pedroazara/estacao-metereologica/ferramentas/cnc-jog/relatorio.html

← Voltar ao painel

OFICINA / DOCUMENTAÇÃO DO LABORATÓRIO

# CNC: guia de JOG e diagnóstico

Inspeção por USB em 7 de outubro de 2026 · estado de comissionamento parcial

A controladora foi identificada como BTT SKR V1.4 Turbo com grblHAL 1.1f, compilação 20250329, cinemática CoreXZ v2.02. Há comunicação USB e aceitação de comandos. A movimentação física, a calibração, os sentidos, os sensores e o spindle não foram validados. Durante os primeiros testes, o operador relatou não perceber movimento.

## O que o painel faz

1. Deixe o monitor serial anterior desconectado: apenas um programa deve acessar a porta USB.
2. Selecione /dev/ttyACM0 · SKR / NXP e clique em Conectar. O painel consulta a identificação, o estado do interpretador e os parâmetros. Conectar não envia movimento, homing, reset ou comando de spindle.
3. Escolha o modo de controle. Para o primeiro teste físico, use Por clique, distância de 0,1 mm, velocidade X/Y de 60 mm/min e Z de 30 mm/min.
4. Confira pessoalmente a área livre e o spindle parado; marque a confirmação e clique em Habilitar JOG.
5. No modo Por clique, clique uma vez no eixo desejado. Aguarde o retorno ao estado Idle. Esse modo não repete movimentos ao segurar.
6. Para interromper um JOG e bloquear os controles, clique em Cancelar JOG ou pressione Esc. O cancelamento usa o byte 0x85 do grblHAL e depende do computador/USB; não substitui uma parada física.
7. Desconecte o painel ao terminar. Para encerrar o servidor, use Ctrl+C no terminal onde ele foi iniciado.

## Controle contínuo: botões e mouse

Depois de validar os sentidos físicos por clique, escolha Segurar para mover e habilite novamente os controles. Mantenha pressionado um botão de direção para solicitar movimento. Soltar cancela; aguarde a confirmação da parada antes de iniciar outro acionamento. As velocidades X/Y e Z continuam independentes. A distância por clique não é usada nesse modo.

No joystick X/Y, pressione e arraste para fora do centro, mantendo pressionado. O eixo predominante determina a direção: apenas X ou Y por vez, sem diagonais. Quanto mais longe do centro, maior a velocidade, de 60 mm/min até o máximo definido no campo X/Y. Voltar ao centro cancela e exige soltar antes de iniciar outro gesto. Mover o mouse sem pressionar não controla a CNC. Para Z, use os botões separados.

Cada acionamento tem limite de 10 segundos e de deslocamento solicitado acumulado: 10 mm em X/Y ou 3 mm em Z. Os deslocamentos de ida e volta contam, não só a posição final. Atingir um limite bloqueia os controles; confira a folga e habilite novamente. Esses limites locais não detectam a borda da máquina nem substituem sensores.

O servidor envia trechos curtos, de até 150 ms de deslocamento comandado, sem fila longa, aguardando confirmação e estado Idle entre os trechos. Portanto, pode haver pequenas pulsações em vez de movimento perfeitamente uniforme. Soltar solicita cancelamento imediato, mas desaceleração e atraso de comunicação existem. Sem renovação do gesto por 600 ms, o servidor cancela e bloqueia. Perder foco, trocar de aba ou de modo também bloqueia. Pacotes atrasados de um acionamento encerrado não devem iniciar outro.

Após cancelar, o painel consulta o interpretador e aguarda confirmação de parada antes de permitir outro movimento. Não há acionamento automático de spindle, homing ou alteração dos parâmetros gravados. Os testes do novo controle usam somente simulador e portas virtuais; o comportamento físico precisa ser validado presencialmente, com spindle desligado e parada física acessível.

Demonstração: selecione “Demonstração · sem CNC”. Um simulador local recebe os comandos e calcula posições virtuais; não abre nenhuma porta serial. O aviso roxo identifica esse modo. A demonstração serve para aprender o painel, não comprova funcionamento da máquina.

## Correção da conexão USB do painel

Na validação com a placa real em 7 de outubro de 2026, o painel anterior recebia identificação e configurações, mas não o estado atual. A conexão foi corrigida para manter DTR ativo na USB nativa LPC e consultar o estado com o comando grblHAL 0x80. A mensagem inicial de boas-vindas agora é tratada dentro da inicialização, com releitura das consultas quando necessário; só uma resposta de estado atualizada permite concluir a conexão. Uma mensagem de reinício ou mudança de sessão depois disso continua bloqueando os controles e exigindo reconexão manual.

Na verificação inicial da reconexão, a placa real respondeu Idle, posição calculada 0,0,0, avanço zero e rotação comandada zero, com controles desabilitados. A intervenção do assistente enviou somente consultas de leitura: nenhum JOG, homing, comando de spindle ou alteração de configuração. Depois dessa verificação inicial, a sessão registrou JOGs acionados pela interface, atualização das posições calculadas e alternância entre Jog e Idle. Ainda falta confirmar visualmente o movimento físico. Os 30 testes automatizados usam simulador ou portas virtuais, não a CNC física. Essa correção confirma comunicação, não movimentação ou segurança mecânica.

## Distância e velocidade são independentes

$J=G91 G21 Z1 F120 solicita deslocamento incremental de +1 mm em Z, a 120 mm/min (2 mm/s). Z-1 inverte o sentido. G91 indica deslocamento relativo e G21 fixa milímetros para esse JOG. O comando não muda o modo de coordenadas do programa principal.

Controle | X / Y | Z
Distância por clique | 0,1 · 0,5 · 1 · 5 mm | 0,1 · 0,5 · 1 · 2 mm
Velocidade permitida no painel | 60–600 mm/min | 30–240 mm/min
Valor inicial | 1 mm · 300 mm/min | 0,5 mm · 60 mm/min

Esses limites são restrições locais do painel para testes iniciais; não são capacidades mecânicas comprovadas. Não alteram os parâmetros gravados na placa. Aceleração e comprimento do movimento limitam a velocidade efetivamente atingida em deslocamentos curtos.

## Identificação comprovada

USB | NXP VCOM Port · VID:PID 1fc9:0083
Porta na inspeção | /dev/ttyACM0
Identificação persistente | /dev/serial/by-id/usb-NXP_VCOM_Port_NXP-77-if00
Placa | BTT SKR V1.4 Turbo
Firmware | grblHAL · [VER:1.1f.20250329:]
Driver de plataforma | [DRIVER:LCP1769] (grafia reportada pelo firmware), versão 250327
Eixos e cinemática | 3 · XYZ · CoreXZ v2.02
Plugins reportados | Trinamic v0.27; FS stream v1.00; FS macro v0.17; SDCARD v1.23

A origem do conjunto mecânico não foi identificada. A hipótese anterior de “Cyclone PCB Factory modificada” não tem comprovação e não deve orientar ligações, firmware ou medidas. A controladora é um componente comercial; isso não identifica um modelo comercial da máquina inteira.

## Parâmetros lidos na inspeção

Parâmetro | Valor lido | Interpretação / limite da evidência
$100 / $101 / $102 | 80,080 / 80,000 / 80,080 | Passos/mm configurados para X/Y/Z; calibração não medida.
$110 / $111 / $112 | 10.000 / 10.000 / 10.000 | Velocidades máximas em mm/min; não são velocidades validadas.
$120 / $121 / $122 | 400 / 400 / 400 | Acelerações em mm/s².
$130 / $131 / $132 | 200 / 200 / 200 | Cursos declarados, não medidos. Não assumir volume físico de 200³ mm.
$20 / $21 / $40 | 0 / 0 / 0 | Limites por software, limites físicos e limitação de JOG desativados.
$140 / $141 / $142 | 900 / 900 / 900 | Correntes configuradas, mA RMS. Corrente real e compatibilidade dos motores não verificadas.
$150 / $151 / $152 | 16 / 16 / 16 | Micropassos configurados.
$338 / $339 | 7 / 5 | Trinamic habilitado em XYZ; sensorless homing configurado em X/Z.
$22 | 563 | Homing habilitado, eixos individuais, switches compartilhados, homing manual permitido e velocidades por eixo. Não exige homing ao iniciar.
$44 / $45 / $46 | 1 / 0 / 0 | A primeira passagem de homing está configurada apenas para X.
$23 / $27 | 0 / 1,000 | Busca no sentido positivo e recuo de 1 mm, conforme ajuda desta compilação.
$30 / $33 | 12.000 / 5.000 | Escala máxima de spindle em rpm e frequência PWM em Hz; não comprova ligação nem rotação real.
$5 / $18 / $14 | 5 / 2 / 1 | Inversões/pull-ups das entradas precisam ser confrontados com a fiação.

O painel lê os parâmetros novamente a cada conexão. O diagnóstico exportado contém os valores da sessão atual; as tabelas deste guia são um registro histórico, não um backup completo para restauração.

## Estado e testes observados

A controladora reportou Idle, FS:0,0 e Pn:HSP. H e S correspondem às entradas de feed hold/cycle start; P, à sonda. A presença simultânea deve ser investigada presencialmente. $LIM retornou [LIMITS:,,,]; isso só descreve o estado naquele instante, não testa a funcionalidade dos sensores.

Foram aceitos JOGs de ida e volta de 0,1 mm nos três eixos, depois 1 mm em X/Y e 0,5 mm em Z, e posteriormente 5 mm em X/Y e 2 mm em Z. As coordenadas calculadas voltaram a 0,0,0. Não houve confirmação visual do movimento; resposta ok e mudança de MPos não provam alimentação, torque, passos efetivos ou ausência de travamento. $SDS respondeu somente ok, sem diagnóstico detalhado de drivers.

Houve um teste de interpretação em modo Check, incluindo G0/G1/M3/M5: ele não era um teste de spindle físico. A sessão depois saiu desse modo por reset lógico. O painel atual não oferece modo Check, reset, desbloqueio de alarmes, homing, spindle ou execução de arquivos.

O offset G54 lido era 24.756,1.403,-0.090. O registro HOME indicava máscara de eixos referenciados igual a zero. Não tratar MPos zero como home mecânico nem usar offsets antigos para cortar. A montagem do SD respondeu ok, mas a listagem retornou error:62 — Directory listing failed; nenhum arquivo foi recuperado.

## Mapa de pinos reportado pelo firmware

Função | Pinos
Passo X / Y / Z | P2.2 / P0.19 / P0.22
Direção X / Y / Z | P2.6 / P0.20 / P2.11
Enable X / Y / Z | P2.1 / P2.8 / P0.21
UART drivers X / Y / Z | P1.10 / P1.9 / P1.8
Limites X / Y / Z | P1.29 / P1.28 / P1.27
Reset / Hold / Start | P0.18 / P0.16 / P0.15
Sonda | P0.10
Spindle enable / direção / PWM | P1.23 / P1.21 / P2.4
Mist / Flood | P1.30 / P1.19

São pinos lógicos declarados pela compilação. Não constituem um diagrama de fiação verificado. Não reconectar componentes com base somente nesta tabela. Em CoreXZ, movimentos X e Z podem envolver motores combinados; não inverter um motor ou aplicar passos/mm de máquina cartesiana sem mapear a transmissão.

## Se os números mudarem e a CNC não mexer

Interrompa os testes e confirme com o responsável pelo laboratório a alimentação de potência dos drivers e motores, o estado dos drivers e seus sinais de enable, e a compatibilidade da compilação CoreXZ com a mecânica instalada. Uma placa alimentada pelo USB pode responder normalmente sem fornecer potência aos motores. Não aumente distâncias ou velocidades para compensar ausência de movimento. Inspeções em conectores ou jumpers devem ser feitas com fonte e USB desconectados.

## Antes de passar de JOG para usinagem

Faltam: observar e medir deslocamentos reais, mapear sentidos, identificar motores/drivers e transmissão, medir o curso útil, verificar fixação e folgas, testar entradas individualmente, resolver HSP, validar parada física e proteções, definir homing compatível com CoreXZ, configurar limites a partir das medidas e caracterizar o spindle e a fixação da ferramenta. Depois disso, preparar peça no CAD/CAM com pós-processador compatível com esta compilação grblHAL, definir zero de trabalho e simular a trajetória. A primeira execução deve ser acompanhada e afastada do material; só depois validar corte. Este painel é destinado ao posicionamento manual, não ao envio de programas de usinagem.

## Fontes e manutenção

- Documentação oficial BTT SKR V1.4 / Turbo (https://github.com/bigtreetech/BIGTREETECH-SKR-V1.3/tree/master/BTT%20SKR%20V1.4)
- grblHAL: comandos em tempo real, incluindo JOG CANCEL 0x85 (https://github.com/grblHAL/core/blob/master/grbl.h)
- Grbl: semântica de JOG incremental (https://github.com/gnea/grbl/wiki/Grbl-v1.1-Jogging)
- Evidências da inspeção: respostas de $I, $$, $HELP SETTINGS, $#, $G, $N, $PINS, $LIM, $SDS e relatórios de estado, registradas na conversa deste laboratório.

Para reabrir: no diretório cnc-jog, execute python3 server.py e abra http://127.0.0.1:8765. Dependência: pyserial 3.5. O serviço aceita conexões apenas deste computador, usa proteção de origem/token e não se reconecta ou habilita movimento automaticamente. Trocar de aba bloqueia os controles; perda de heartbeat por 2 s ou do estado serial por 1,5 s solicita cancelamento. Se o cabo for retirado, não há garantia de entrega do cancelamento: o limite de distância por comando reduz a exposição, e a parada física continua necessária.
