pedroazara/estacao-metereologica/docs/README.md

# Documentação técnica

- [Documento consolidado](versoes/2026-10-10-2cd5977-local/documentacao-tecnica.md): captura do estado analisado em 10/10/2026, com imagens, fontes, limitações e evidências.
- [Organização e limpeza](organizacao/2026-10-10/relatorio.md): estrutura atual, movimentos, remoções e verificações.
- [Arquitetura e telemetria](04-telemetria.md): fluxo atual e decisões anteriores identificadas como históricas.
- [Base Raspberry Pi](05-base-raspberry-pi.md): operação atual por HTTP e notas de implantação.
- [Hardware](../hardware/README.md), [firmware](../firmware/README.md) e [aplicativo](../app/README.md): entradas de cada componente.

Os documentos `01`, `02` e `03` registram conhecimentos de conexão, protocolo
WTG e Kalman. São referências técnicas históricas. Os testes/exercícios antigos
foram removidos a pedido; a matemática e os registros documentais foram mantidos.
A pasta `versoes` preserva a captura da análise, mesmo quando um arquivo-fonte
antigo deixa de fazer parte da árvore ativa.
