pedroazara/estacao-metereologica/docs/organizacao/2026-10-10/inventario-readmes.md

# Inventário atual de READMEs e variantes

Data: 10/10/2026, após organização e limpeza. Ambientes virtuais, dependências
de compilação e metadados Git não são documentação autoral.

Total na árvore de autoria/referência: **13**. Sem pendências.

| Caminho | Situação |
|---|---|
| `README.md` | Criado ou atualizado para a estrutura atual |
| `app/README.md` | Criado ou atualizado para a estrutura atual |
| `docs/README.md` | Criado ou atualizado para a estrutura atual |
| `ferramentas/README.md` | Criado ou atualizado para a estrutura atual |
| `ferramentas/cnc-jog/LEIA-ME.txt` | Revisado sem alteração; guia local continua válido |
| `ferramentas/cnc-jog/exemplos/LEIA_ANTES_DO_RASCUNHO.txt` | Revisado sem alteração; guia local continua válido |
| `firmware/README.md` | Criado ou atualizado para a estrutura atual |
| `hardware/README.md` | Criado ou atualizado para a estrutura atual |
| `hardware/skylog/README.md` | Criado ou atualizado para a estrutura atual |
| `hardware/skylog/bibliotecas/README.md` | Criado ou atualizado para a estrutura atual |
| `hardware/skylog/bibliotecas/Sensores_Modulos/originais/gy302/readme.md` | Excluído: original de terceiro, preservado com procedência/licença |
| `hardware/skylog/fabricacao/README.md` | Criado ou atualizado para a estrutura atual |
| `src/README.md` | Criado ou atualizado para a estrutura atual |

Relatórios de cobertura são registros de revisão e não entram no total de READMEs.
