pedroazara/estacao-metereologica/hardware/skylog/modelos/esp32-wroom-32s-nodemcu-32s-1.snapshot.8/ESP32Wroom4.STEP

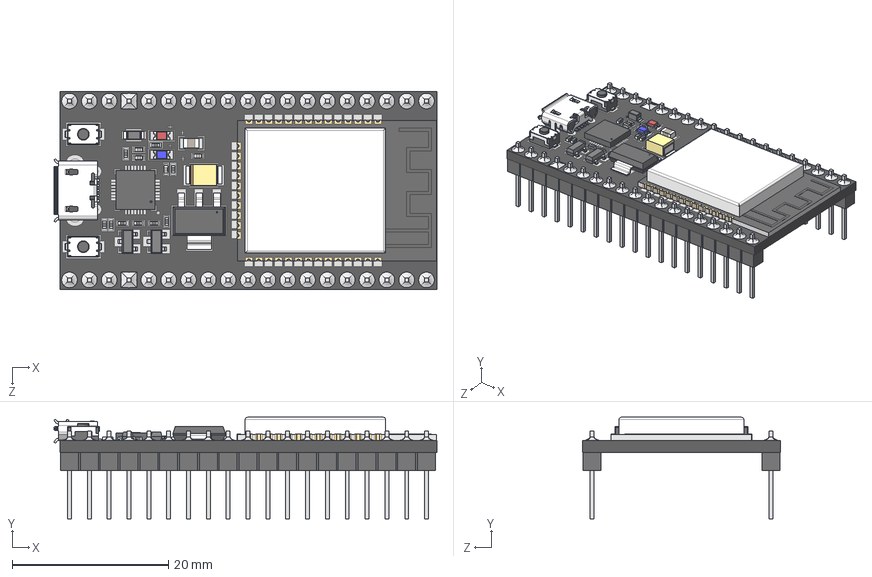
[picture p2: CAD file, 2026-10-10]
hardware/skylog/modelos/esp32-wroom-32s-nodemcu-32s-1.snapshot.8/ESP32Wroom4.STEP
49.0 x 13.0 x 25.4 mm
nodeMCU
J3Y_transistor x 2
ESP_Wroom
AMS1117
SILABS
push button x 2
led_red
led_blue
capp
1mm x 4
shotkeydiode
SMD resistor x 9
Micro USB-B Female 5Pin SMD
