pedroazara/estacao-metereologica/docs/organizacao/2026-10-10/verificacao-estrutura.txt

Contagens: {'links': 155, 'bibliotecas': 12, 'modelos': 16, 'footprints': 16}
Resultado: OK
Limites: não valida eletricamente a placa, bibliotecas padrão ou URLs externas.
