pedroazara/estacao-metereologica/(list of files, drawings)

Other design files:
hardware/skylog/originais/conversor-rs485/esquematico-easyeda.json
hardware/skylog/originais/conversor-rs485/pcb-easyeda.json
