pedroazara/estacao-metereologica/docs/versoes/2026-10-10-2cd5977-local/fontes/skylog.kicad_sch

## KiCad design docs/versoes/2026-10-10-2cd5977-local/fontes/skylog.kicad_sch (2026-10-10)

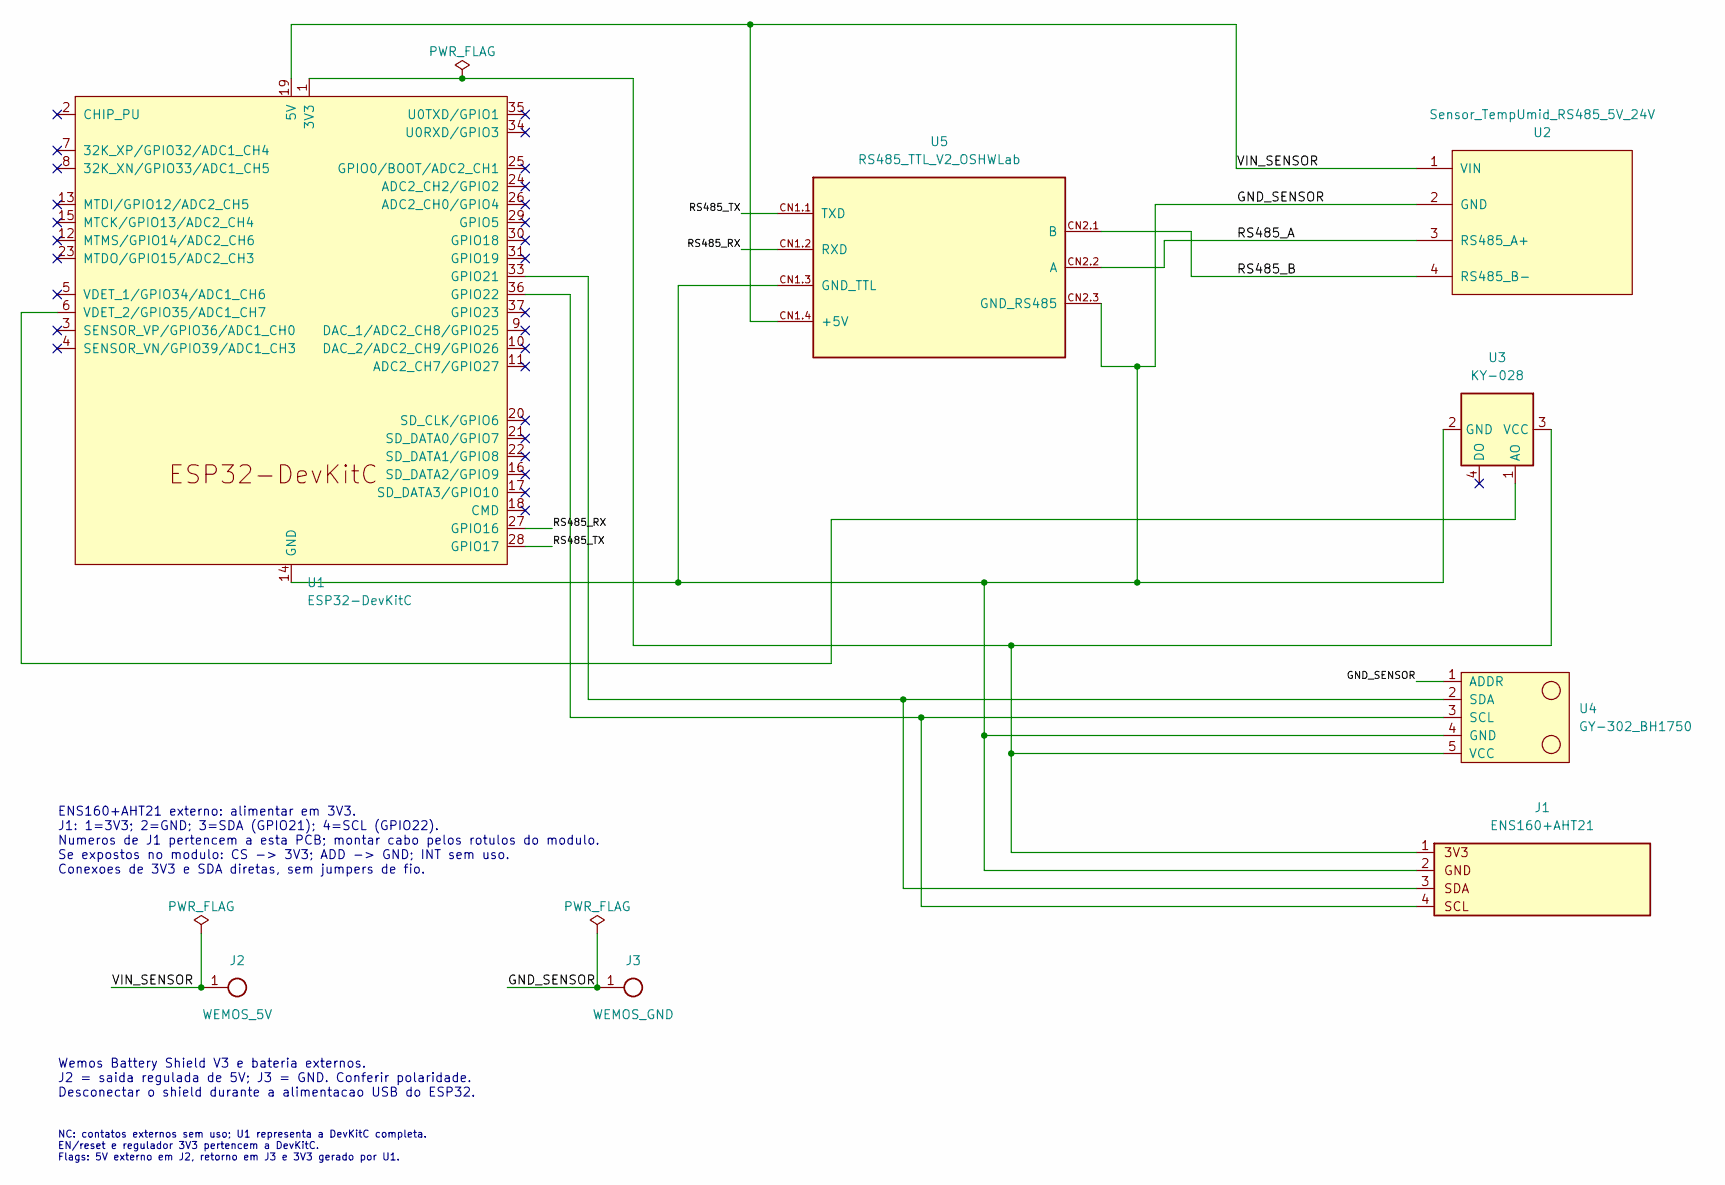
[picture p3: schematic skylog.kicad_sch]

Parts:
J1: ENS160+AHT21; ENS160_AHT21_1x04_P2.54mm
J2: WEMOS_5V; Wire_Pad_D1.2mm
J3: WEMOS_GND; Wire_Pad_D1.2mm
U1: ESP32-DevKitC; ESP32-DevKitC_BoardEdge
U2: Sensor_TempUmid_RS485_5V_24V; PinSocket_1x04_P2.54mm_Vertical
U3: KY-028; KY-028_Conector_1x04_P2.54mm
U4: GY-302_BH1750; GY-302_Conector_1x05_P2.54mm
U5: RS485_TTL_V2_OSHWLab; RS485_TTL_V2_OSHWLab_PadGeometry

Connections:
GND_SENSOR: J1.2, J3.1, U1.14 (GND), U1.32 (GND), U1.38 (GND), U2.2 (GND), U3.2 (GND), U4.1 (ADDR), U4.4 (GND), U5.CN1.3 (GND_TTL), U5.CN2.3 (GND_RS485)
unnamed: J1.1, U1.1 (3V3), U3.3 (VCC), U4.5 (VCC)
unnamed: J1.3, U1.33 (GPIO21), U4.2 (SDA)
unnamed: J1.4, U1.36 (GPIO22), U4.3 (SCL)
unnamed: U1.6 (VDET_2/GPIO35/ADC1_CH7), U3.1 (AO)
RS485_A: U2.3 (RS485_A+), U5.CN2.2 (A)
RS485_B: U2.4 (RS485_B-), U5.CN2.1 (B)
RS485_RX: U1.27 (GPIO16), U5.CN1.2 (RXD)
RS485_TX: U1.28 (GPIO17), U5.CN1.1 (TXD)
VIN_SENSOR: J2.1, U1.19 (5V), U2.1 (VIN), U5.CN1.4 (+5V)

Notes on the sheet:
ENS160+AHT21 externo: alimentar em 3V3. J1: 1=3V3; 2=GND; 3=SDA (GPIO21); 4=SCL (GPIO22). Numeros de J1 pertencem a esta PCB; montar cabo pelos rotulos do modulo. Se expostos no modulo: CS -> 3V3; ADD -> GND; INT sem uso. Conexoes de 3V3 e SDA diretas, sem jumpers de fio.
Wemos Battery Shield V3 e bateria externos. J2 = saida regulada de 5V; J3 = GND. Conferir polaridade. Desconectar o shield durante a alimentacao USB do ESP32.
NC: contatos externos sem uso; U1 representa a DevKitC completa. EN/reset e regulador 3V3 pertencem a DevKitC. Flags: 5V externo em J2, retorno em J3 e 3V3 gerado por U1.
