pedroazara/estacao-metereologica/(commit log)

2026-08-03 feat: add initial implementation of WTGAHRS3 Modbus RTU driver and utility scripts
    - Created `scan_barramento.py` for discovering the WTGAHRS3 sensor over serial ports.
    - Implemented `varredura_registradores.py` for brute-force scanning of register map to find correct decoding for position.
    - Developed `wtgahrs3.py` as the main driver for interacting with the WTGAHRS3 sensor, including methods for reading position, environment, and IMU data.
    - Added support for various baud rates and Modbus addresses.
    - Included error handling and user-friendly messages for troubleshooting.
2026-08-04 feat: integrate Kalman filter and inertial navigation for improved positioning
    - Added Kalman filter and inertial navigation classes to enhance GPS data processing.
    - Implemented functions for registering points and fusing GPS with inertial data.
    - Updated state management to include Kalman filter and inertial navigation data.
    - Modified the sensor thread to incorporate Kalman filter predictions and corrections.
    - Enhanced the web interface to display Kalman filter and inertial navigation metrics.
    - Removed the unused varredura_registradores.py script to streamline the codebase.
2026-08-17 feat: add scripts for sensor testing and data collection
    - Introduced `registrar_caminhada.py` for raw walking data logging with GPS and IMU readings.
    - Added `verificar_bussola.py` to empirically test the presence and functionality of the magnetometer in the WTGAHRS3 sensor.
    - Created `verificar_eixos.py` to verify the signal conventions of the WTGAHRS3, ensuring correct axis readings.
    - Implemented unit tests in `test_filtro_kalman.py` for various components of the Kalman filter and step detection algorithms.
2026-08-17 Add telemetry server and simulation for MQTT data
    - Implemented `servidor_telemetria.py` to subscribe to MQTT broker, process telemetry data from ESP32, and serve a web dashboard.
    - Created `simular_estacao.py` to simulate an MQTT station publishing GPS and IMU data for testing purposes.
    - Added Mosquitto configuration file `mosquitto-estacao.conf` for proper broker setup.
    - Updated `requirements.txt` to include `paho-mqtt` for MQTT communication.
2026-08-18 feat: adicionar monitor de terminal e serviço de telemetria para a base Raspberry Pi
2026-08-20 feat: initialize Flutter project with pubspec.yaml and widget tests
    - Created pubspec.yaml for Flutter project configuration, including dependencies and environment settings.
    - Added initial widget test to verify the app starts with the correct UI elements.
    - Updated firmware documentation to include partition scheme requirements for BLE functionality.
    - Implemented BLE service for the station, including characteristics for status, position, ambient data, IMU data, and configuration.
    - Enhanced firmware to support adjustable configuration via BLE, persisting settings with Preferences.
    - Modified main firmware loop to maintain BLE advertising and apply configuration changes from the app.
2026-08-26 checkpoint: app Flutter (BLE, Kalman, mapa, sync), base como banco SQLite, firmware BLE
    Trabalho em progresso de 24-25/08. Ponto de seguranca antes da simplificacao.
2026-08-26 painel de analise por temperatura + corrige perda de coleta
    - Base: painel colore cada ponto do trajeto pela temperatura (escala + tooltip),
    /sessao devolve pontos com temp/umid/vel. Manifesto por tamanho: reenvio maior
    da mesma sessao substitui e reprocessa.
    - App: gravador faz flush periodico (2s). Sem isso, sincronizar sem parar - ou
    fechar o app - perdia a coleta inteira (foi o que zerou as 4 primeiras sessoes).
2026-08-26 app simples: so GPS do telefone + ambiente, sem IMU/Kalman
    - Remove IMU, Kalman (lib/kalman, tela_sensores), o vai-e-volta de posicao pelo
    ESP. Posicao = GPS do telefone gravado direto; ambiente = ESP por BLE.
    - Trajetoria comeca ao apertar Gravar (ble.trilha).
    - Corrige: base sempre 'fora de alcance' (verificava /dados, removido -> /sessoes).
    - Corrige: config nao atualizava sem reiniciar (faltava assinar a cfg por notify).
    - Base: processar_sessao sem Kalman; cada ponto de GPS leva a temperatura.
2026-08-26 gravacao a prova de falha: timer de 1s grava a posicao atual
    O stream de GPS pode espacar/pausar os eventos, e a gravacao dependia deles -
    por isso a coleta vinha vazia mesmo com o GPS mostrando posicao no mapa. Agora,
    durante a gravacao, um timer de 1 Hz le a posicao atual e grava, garantido
    enquanto houver fix. Mais: aba Sessoes ganha 'toque para ver' - mostra linhas,
    pontos de GPS e um trecho, e avisa se o arquivo esta vazio.
2026-08-27 corrige o envio: coleta chegava com 0 bytes na base
    Causa: o HttpClient do Dart, sem contentLength definido, manda o corpo em
    chunked (sem Content-Length). A base lia so Content-Length e recebia 0 bytes -
    gravava arquivo vazio embora o telefone tivesse os pontos. Sintoma era 'grava
    certo, mas na base chega 0'.
    Dois lados:
    - app: define req.contentLength antes de enviar.
    - base: _ler_corpo() aceita Content-Length E chunked (a prova de futuro).
    Verificado contra o Pi: envio chunked que antes dava 0 agora chega com 36
    linhas / 30 pontos.
2026-08-27 painel de analise por temperatura + corrige perda de coleta
    - Painel do Pi: mapa Leaflet/OpenStreetMap real (igual ao do app), no lugar do
    canvas em coordenadas locais. Os tiles sao buscados pelo navegador de quem
    abre o painel, nao pelo Pi - nao pesa nele. Pontos coloridos por temperatura
    com popup ao clicar, marcadores de inicio/fim, escala lateral.
    - /sync: manifesto por TAMANHO em vez de so nome. Um reenvio MAIOR (sessao
    sincronizada de novo apos gravar mais) e aceito e reprocessado; antes um
    reenvio era sempre 'ja_tinha' e a parte nova se perdia.
2026-08-27 corrige GPS lento e trajetoria errada: intervalo padrao era 5s
    Causa raiz, documentada no proprio pacote geolocator_android: sem
    intervalDuration explicito, o Android aplica 5000ms de intervalo por padrao.
    Andando a pe (~1,4 m/s), cada fix ficava a uns 7 m do anterior - poucos pontos,
    'atualiza devagar', trajetoria em degraus.
    Piorou com uma correcao anterior errada (ff67b9c): um timer de 1s que relia a
    ULTIMA posicao em cache e gravava de novo, achando que era amostra nova -
    resultado, pontos duplicados da mesma posicao intercalados com os poucos
    pontos reais, distorcendo o tracado. Aquele bug ('grava 0') era na verdade o
    upload (be8ae78), nao a captura - a correcao do timer resolveu o sin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
2026-08-27 feat: add planning functionality for area measurement
    - Introduced a new Python module `planejamento.py` for managing area planning.
    - Implemented functions to create, update, list, and delete plans in the SQLite database.
    - Added validation for the drawing strokes to ensure correct format and values.
    - Enhanced the `servidor_telemetria.py` to handle new endpoints for plan management.
    - Updated the HTML and JavaScript in `servidor_telemetria.py` to support user interaction for planning areas on the map.
    - Integrated the painting feature allowing users to define areas for measurement using a brush tool.
    - Implemented functionality to activate and deactivate plans for specific devices.
2026-10-01 chore: checkpoint Skylog and bundle portable KiCad project
    Preserve the current app, firmware, Python telemetry/planning, documentation,
    and historical SDK work, including local WitMotion source adaptations.
    Keep external sensor connector libraries and the ESP32 symbol/footprint inside
    the KiCad project, with project-relative model paths for Linux and Windows.
    Record the current sensor scope and pending wiring and single-layer routing
    work, and exclude generated files, caches, local history, and backup archives.
    Validation: 66 Flutter tests and 7 Python unit tests passed; Python sources
    parse successfully. Flutter analysis has one existing braces style notice.
    KiCad 10 loads the project and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
2026-10-02 Refactor KiCad project files by removing unused libraries and updating footprints
    - Removed references to unused libraries "Sensores_Modulos" and "ESP32" from fp-lib-table and sym-lib-table.
    - Updated footprint references in the schematic for ESP32 from "ESP32:ESP32-DevKitC" to "PCM_Espressif:ESP32-DevKitC".
    - Adjusted footprint positions and properties for KY-028 and GY-302 components in the PCB layout, including rotation and alignment changes.
    - Modified net connections and segment paths in the PCB layout for improved routing and clarity.
    - Cleaned up designators in the project file, removing unused designators for better organization.
2026-10-02 Add new footprints for wire jumpers and pads; update symbol library table
    - Created a new footprint for a 10mm wire jumper (Wire_Jumper_P10.00mm) with specifications for soldered connections and pad dimensions.
    - Added a footprint for a wire pad (Wire_Pad_D1.2mm) designed for insulated power wire connections, including pad and drill sizes.
    - Updated the symbol library table to include additional libraries for Espressif components, sensor modules, and standard power symbols for KiCad 10.
